kavers1/RobotKit/hardware/samenstelling v2_3.png

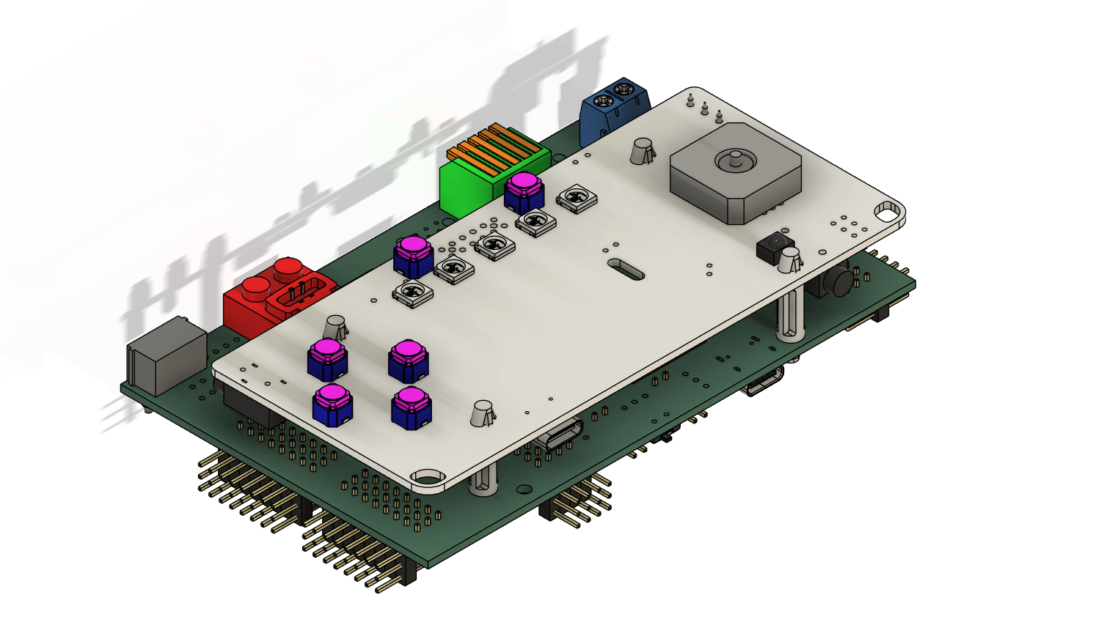
hardware/samenstelling v2_3.png
