kavers1/RobotKit/firmware/resources/rc.pdf

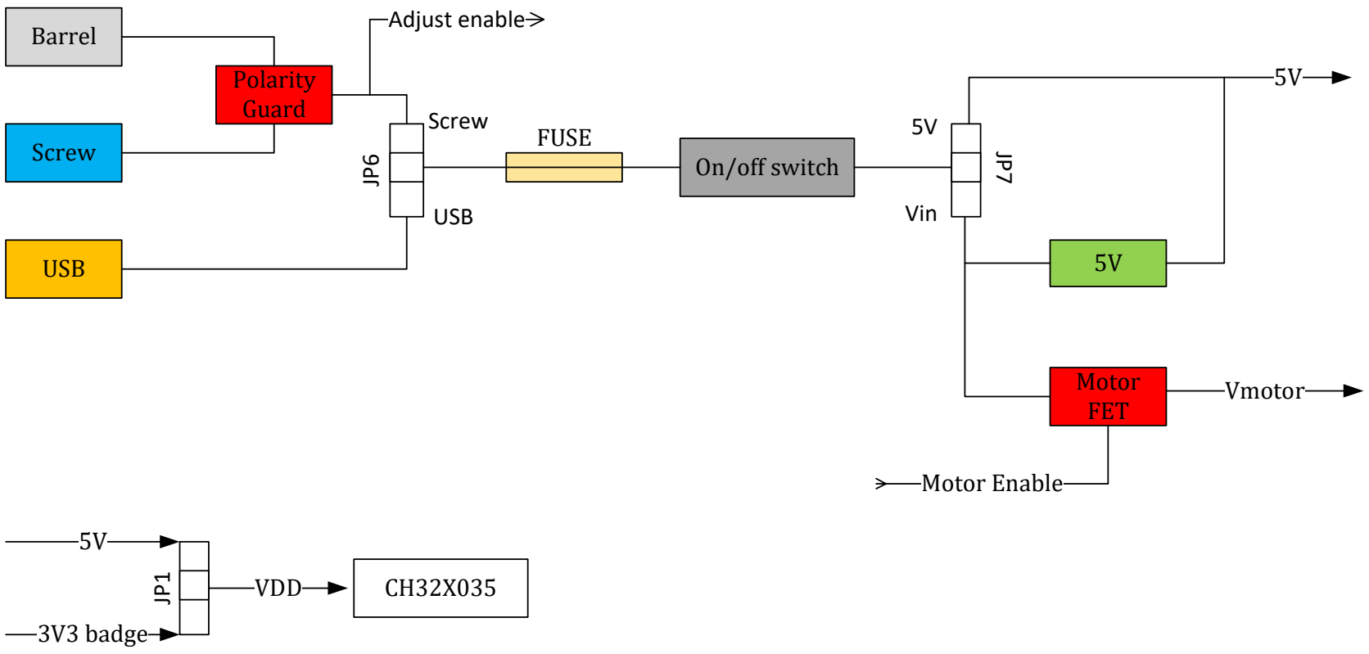
[picture p2: figure]
Barrel; Screw; Polarity Guard; USB; Adjust enable; FUSE; On/off switch; Motor FET; Vmotor; Motor Enable; Vin; 3V3 badge; VDD
