kavers1/RobotKit/hardware/samenstelling v2_1.png

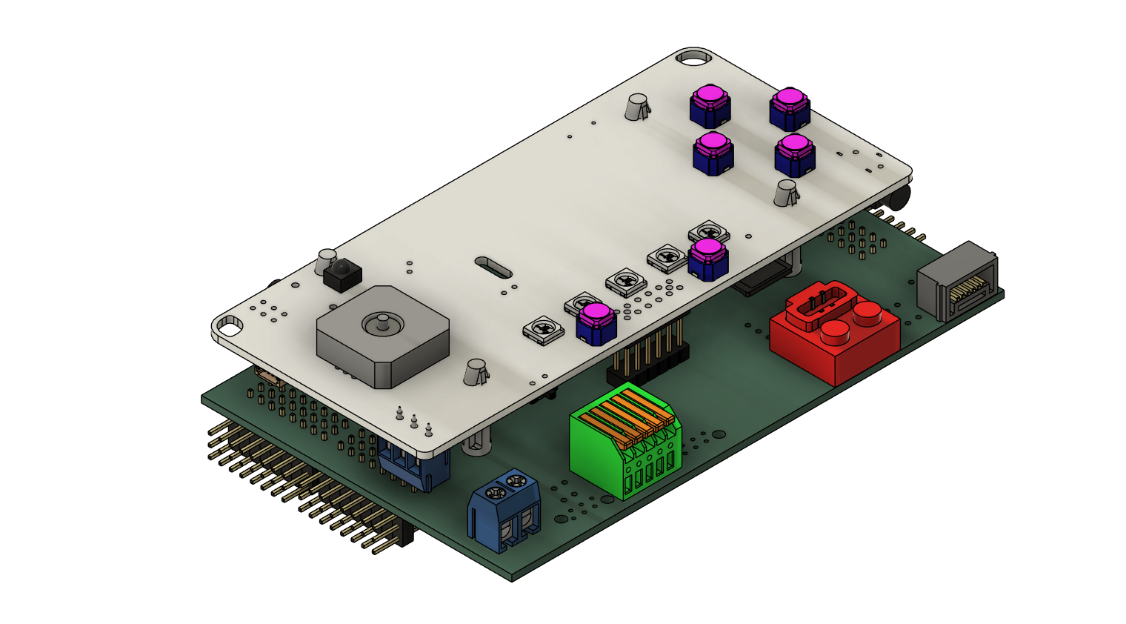
hardware/samenstelling v2_1.png
