kavers1/RobotKit/hardware/samenstelling v2_2.png

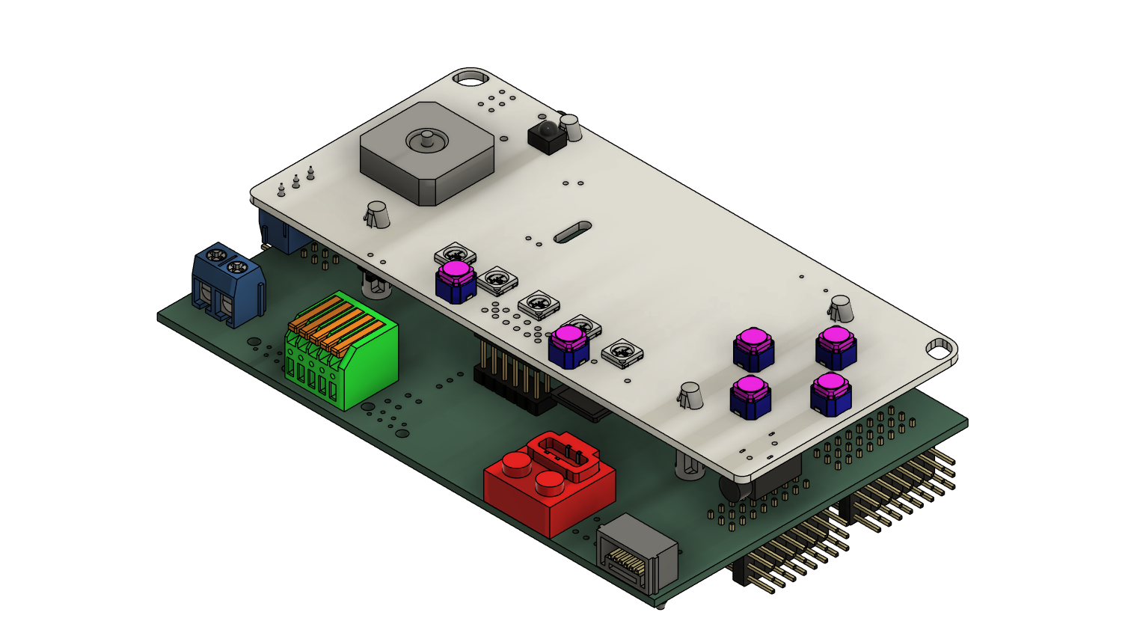
hardware/samenstelling v2_2.png
