kavers1/RobotKit/hardware/samenstelling v2_4.png

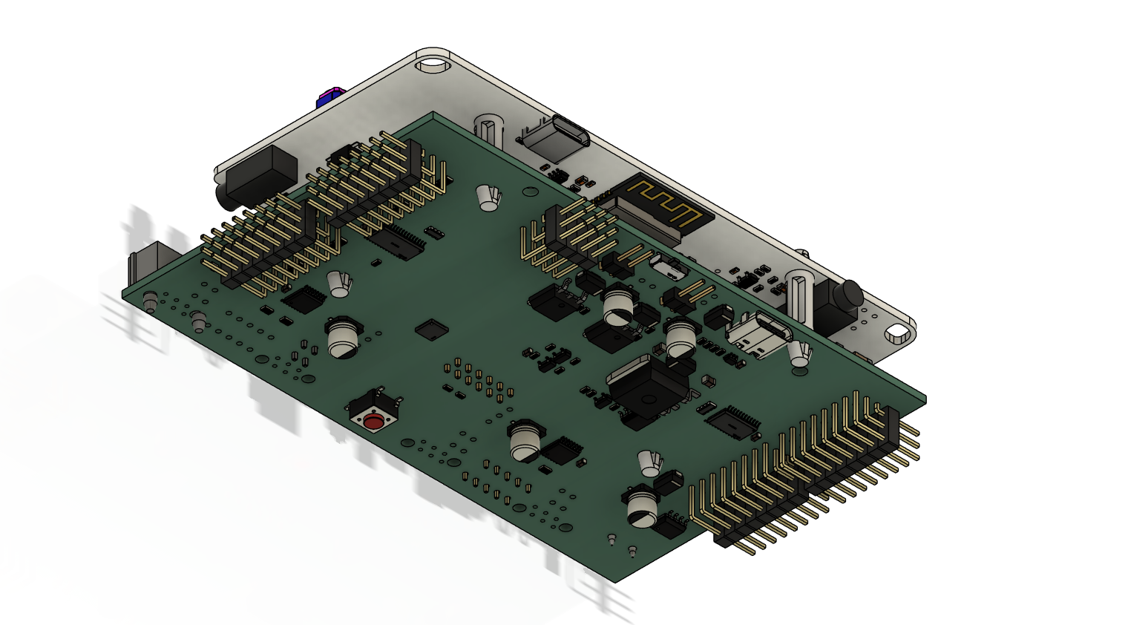
hardware/samenstelling v2_4.png
