kavers1/RobotKit/(commit log)

2026-07-12 merged different frameworks
2026-07-13 cleanup of frameworks
2026-07-13 clean up of frameworks
2026-07-19 PCB info
    [badge26_motor_expansion-CuBottom.gbr, badge26_motor_expansion-CuTop.gbr, badge26_motor_expansion-EdgeCuts.gbr, badge26_motor_expansion-MaskBottom.gbr, badge26_motor_expansion-MaskTop.gbr, badge26_motor_expansion-NPTH.drl, badge26_motor_expansion-PTH.drl, badge26_motor_expansion-SilkBottom.gbr]
2026-07-19 debug pd power ok
2026-07-21 rename timer code files
2026-07-21 pwm update
2026-07-22 I2C first scan
